s277941/ESE-project/(list of files, cad)

Other CAD files:
ORCAD_PERSONAL_LIBRARY/FOOTPRINTS/0603_c.psm
ORCAD_PERSONAL_LIBRARY/FOOTPRINTS/0603_l.psm
ORCAD_PERSONAL_LIBRARY/FOOTPRINTS/0603_r.psm
ORCAD_PERSONAL_LIBRARY/FOOTPRINTS/an043_patch_antenna.psm
ORCAD_PERSONAL_LIBRARY/FOOTPRINTS/beadc1608x95n.psm
ORCAD_PERSONAL_LIBRARY/FOOTPRINTS/blm18he152sn1.psm
ORCAD_PERSONAL_LIBRARY/FOOTPRINTS/capc0603x33n.psm
ORCAD_PERSONAL_LIBRARY/FOOTPRINTS/indc1608x90n.psm
ORCAD_PERSONAL_LIBRARY/FOOTPRINTS/molex_105164-0001.psm
ORCAD_PERSONAL_LIBRARY/FOOTPRINTS/my_qmatrix_button.psm
ORCAD_PERSONAL_LIBRARY/FOOTPRINTS/q-matrix-button.psm
ORCAD_PERSONAL_LIBRARY/FOOTPRINTS/qfn45p400x400x90-29n-d.psm
ORCAD_PERSONAL_LIBRARY/FOOTPRINTS/qmatrix_button.psm
ORCAD_PERSONAL_LIBRARY/FOOTPRINTS/qmatrix_button_top.psm
ORCAD_PERSONAL_LIBRARY/FOOTPRINTS/resc1608x50n.psm
ORCAD_PERSONAL_LIBRARY/FOOTPRINTS/samtec_ftsh-105-01-l-d-k.psm
ORCAD_PERSONAL_LIBRARY/FOOTPRINTS/sm02b-srss-tblfsn.psm
ORCAD_PERSONAL_LIBRARY/FOOTPRINTS/smd_cc2640r2f_rgz_48.psm
ORCAD_PERSONAL_LIBRARY/FOOTPRINTS/smd_max1555.psm
ORCAD_PERSONAL_LIBRARY/FOOTPRINTS/smd_max17048.psm
ORCAD_PERSONAL_LIBRARY/FOOTPRINTS/smd_max1759.psm
ORCAD_PERSONAL_LIBRARY/FOOTPRINTS/smd_sc20s-7pf20ppm.psm
ORCAD_PERSONAL_LIBRARY/FOOTPRINTS/smd_smlp36.psm
ORCAD_PERSONAL_LIBRARY/FOOTPRINTS/smd_tsx-3225240000mf15x-ac3.psm
ORCAD_PERSONAL_LIBRARY/FOOTPRINTS/sw_pcm12smtr.psm
