s277941/ESE-project/(list of files, drawings)

Other design files:
BLE_TH_Sensor/BLE_TH_SENSOR.DSN
BLE_TH_Sensor/ble_th_sensor.opj
FullAdder/FULLADDER.DSN
FullAdder/FullAdder.opj
Launchpad/LAUNCHPAD.DSN
Launchpad/Launchpad.opj
ORCAD_PERSONAL_LIBRARY/ORCAD_MY_LIBRARY.OLB
ORCAD_PERSONAL_LIBRARY/orcad_my_library.opj
