s277941/ESE-project/Launchpad/allegro/art_param.txt

DEVICE-TYPE           GERBER_RS274X
OUTPUT-UNITS          MM
FILM-SIZE             11000000 12000000
FORMAT                2.5
ABORT-ON-ERROR        NO
SCALE                 1
SUPPRESS-LEAD-ZEROES  YES
SUPPRESS-TRAIL-ZEROES NO
SUPPRESS-EQUAL        YES
UNDEF-APT-CONT        NO
