s277941/ESE-project/BLE_TH_Sensor/nc_param.txt

INTEGER-PLACES         3
DECIMAL-PLACES         3
X-OFFSET               0.000000
Y-OFFSET               0.000000
FEEDRATE               1
COORDINATES            ABSOLUTE
OUTPUT-UNITS           METRIC
TOOL-ORDER             INCREASING
REPEAT-CODES           NO
SUPPRESS-LEAD-ZEROES   YES
SUPPRESS-TRAIL-ZEROES  NO
SUPPRESS-EQUAL         NO
TOOL-SELECT            YES
OPTIMIZE_DRILLING      NO
ENHANCED_EXCELLON      YES
HEADER                 none
LEADER                 12
CODE                   ASCII
SEPARATE               YES
SEPARATE-ROUTING       NO
DRILLING               LAYER-PAIR
BACKDRILL              NO
CAVITY                 NO
COUNTER                NO
TOLERANCE_DRILL        YES
TOLERANCE_TRAVEL       NO
TOOL_SIZE              NO
ROTATION               NO
NON_STANDARD           NO
TOTAL_DRILL            NO
SEPARATE_SLOT          NO
SUPPRESS_TOLERANCE     NO
SUPPRESS_TOOLSIZE      NO
SUPPRESS_ROTATION      NO
