s277941/ESE-project/(commit log)

2020-11-21 Added part MAX1759 to library
    [ORCAD_MY_LIBRARY.OLB, ble_th_sensor.opj, orcad_my_library.opj]
2020-11-23 Added part TI-CC2640
    [ORCAD_MY_LIBRARY.OLB, orcad_my_library.opj]
2020-11-25 touch sensor
    [FULLADDER.DSN, FULLADDER.brd, FullAdder.opj, ORCAD_MY_LIBRARY.OLB, orcad_my_library.opj]
2020-11-25 Added more parts
    [ORCAD_MY_LIBRARY.OLB, orcad_my_library.opj]
2020-11-27 Created launchpad project
    [LAUNCHPAD.DSN, Launchpad.opj]
2020-11-27 Some work done
    [Conn_Molex_51021-0300.olb, LAUNCHPAD.DSN, Launchpad.opj, ORCAD_MY_LIBRARY.OLB, orcad_my_library.opj]
2020-11-27 Test push andrea
    [LAUNCHPAD.DSN]
2020-11-27 Everything resetted
    [LAUNCHPAD.DSN]
2020-11-27 General fix
    [Conn_Molex_51021-0300.olb, Launchpad.opj]
2020-11-28 Inserted title
    [LAUNCHPAD.DSN, Launchpad.opj]
2020-11-28 battery charger
    [Conn_Molex_1051640001.olb, LAUNCHPAD.DSN, Launchpad.opj]
2020-11-28 level meter
    [LAUNCHPAD.DSN]
2020-11-28 Completed power page
    [LAUNCHPAD.DSN, Launchpad.opj]
2020-11-29 Started drawing schematic for the touch-sensor
    [AT42QT2160-MMUR.OLB, LAUNCHPAD.DSN, Launchpad.opj, ORCAD_MY_LIBRARY.OLB, orcad_my_library.opj]
2020-12-01 Finished drawing touch sensor
    [LAUNCHPAD.DSN, Launchpad.opj]
2020-12-01 Started drawing the schematic of the microcontroller
    [BLM18HE152SN1D.OLB, LAUNCHPAD.DSN, Launchpad.opj, ORCAD_MY_LIBRARY.OLB, SC20S-7PF20PPM.OLB, TSX-3225240000MF15X-AC3.OLB, sc20s-7pf20ppm.opj, tsx-3225240000mf15x-ac3.opj]
2020-12-02 Finished schematic
    [LAUNCHPAD.DSN, Launchpad.opj, ORCAD_MY_LIBRARY.OLB, orcad_my_library.opj]
2020-12-03 Fixed some errors
    [LAUNCHPAD.DSN, Launchpad.opj, ORCAD_MY_LIBRARY.OLB, orcad_my_library.opj]
2020-12-04 Added JTAG
    [FTSH-105-01-L-D-RA-K.OLB, LAUNCHPAD.DSN, Launchpad.opj, ORCAD_MY_LIBRARY.OLB, orcad_my_library.opj]
2020-12-04 Some changes
    [Launchpad.opj]
2020-12-05 All the parts merged in my_orcad_personal_library.olb
    [LAUNCHPAD.DSN, Launchpad.opj, ORCAD_MY_LIBRARY.OLB, conn_molex_1051640001.opj, conn_molex_51021-0300.opj]
2020-12-05 Deleted not needed .olb library files
    [AT42QT2160-MMUR.OLB, BLM18HE152SN1D.OLB, Conn_Molex_1051640001.olb, Conn_Molex_51021-0300.olb, FTSH-105-01-L-D-RA-K.OLB, Launchpad.opj, SC20S-7PF20PPM.OLB, TSX-3225240000MF15X-AC3.OLB]
2020-12-05 Started drawing footprints
    [Launchpad.opj, smd_cc2640r2f_rgz_48.psm, smd_max1555.psm, smd_max1759.psm]
2020-12-05 Added more footprints
    [orcad_my_library.opj, qfn45p400x400x90-29n-d.psm, smd_max17048.psm]
2020-12-07 More footprints
    [LAUNCHPAD.DSN, Launchpad.opj, ORCAD_MY_LIBRARY.OLB, molex_105164-0001.psm, orcad_my_library.opj, smd_sc20s-7pf20ppm.psm, smd_tsx-3225240000mf15x-ac3.psm]
2020-12-07 Added new switch
    [LAUNCHPAD.DSN, Launchpad.opj, ORCAD_MY_LIBRARY.OLB, orcad_my_library.opj, sw_pcm12smtr.psm]
2020-12-08 Completed drawing footprints
    [LAUNCHPAD.DSN, Launchpad.opj, ORCAD_MY_LIBRARY.OLB, beadc1608x95n.psm, capc0603x33n.psm, indc1608x90n.psm, orcad_my_library.opj, resc1608x50n.psm]
2020-12-10 Almost finished schematic!
    [LAUNCHPAD.DSN, Launchpad.opj, ORCAD_MY_LIBRARY.OLB, orcad_my_library.opj, qfn45p400x400x90-29n-d.psm, smd_cc2640r2f_rgz_48.psm]
2020-12-10 Completed all the footprints
    [0603_c.psm, 0603_l.psm, 0603_r.psm, LAUNCHPAD.DSN, Launchpad.opj, ORCAD_MY_LIBRARY.OLB, an043_patch_antenna.psm, blm18he152sn1.psm]
2020-12-11 Added Qmatrix-Button
    [LAUNCHPAD.DSN, Launchpad.opj, ORCAD_MY_LIBRARY.OLB, orcad_my_library.opj, q-matrix-button.psm]
2020-12-12 Completed schematic and all the footprints, ready for brd!
    [LAUNCHPAD.DSN, Launchpad.opj, ORCAD_MY_LIBRARY.OLB, my_qmatrix_button.psm, orcad_my_library.opj, qmatrix_button.psm]
2020-12-13 Added touch sensor on etch top
    [qmatrix_button_top.psm]
2020-12-14 Everything is ready and we can start drawing the PCB!
    [LAUNCHPAD.DSN, qmatrix_button_top.psm]
2020-12-14 Now everything of the schematic is finished!
    [LAUNCHPAD.DSN, Launchpad.opj, ORCAD_MY_LIBRARY.OLB, orcad_my_library.opj]
2020-12-14 Started PCB design
    [LAUNCHPAD.DSN, LAUNCHPAD.brd, Launchpad.opj, ORCAD_MY_LIBRARY.OLB, cases.cfg, molex_105164-0001.psm, orcad_my_library.opj, smd_smlp36.psm]
2020-12-15 Checkpoint 0
    [LAUNCHPAD.brd, qfn45p400x400x90-29n-d.psm]
2020-12-15 All the components putted on the PCB
    [LAUNCHPAD.DSN, LAUNCHPAD.brd, Launchpad.opj, orcad_my_library.opj]
2020-12-15 Fixed Antenna and preliminary position setted!
    [LAUNCHPAD.DSN, LAUNCHPAD.brd, LAUNCHPAD_checkpoint0.brd, Launchpad.opj]
2020-12-15 Drawed a line
    [LAUNCHPAD.brd, Launchpad.opj]
2020-12-16 Changed something!
    [LAUNCHPAD.DSN, LAUNCHPAD.brd, LAUNCHPAD_checkpoint0.brd, Launchpad.opj]
2020-12-16 Almost finished everything!
    [LAUNCHPAD.brd, cases.cfg]
2020-12-16 Completed almost everything
    [LAUNCHPAD.DSN, LAUNCHPAD.brd, LAUNCHPAD_checkpoint0.brd, Launchpad.opj]
2020-12-17 Started routing matrix
    [LAUNCHPAD.brd]
2020-12-18 Some modifications
    [LAUNCHPAD.brd]
2020-12-21 Minor changes
    [LAUNCHPAD.brd]
2020-12-21 Others minor changes
    [LAUNCHPAD.brd]
2020-12-21 Updated schematics
    [LAUNCHPAD.DSN, Launchpad.opj]
2020-12-21 Gerbers exported
    [LAUNCHPAD.brd, art_param.txt, nc_param.txt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]
2021-01-11 Added more comments to schematic, started rev 1.1
    [LAUNCHPAD.DSN, LAUNCHPAD_checkpoint0.brd]
2021-01-16 Improved the micro 01
    [LAUNCHPAD.brd]
2021-01-16 Improved also the touch sensor maybe...
    [LAUNCHPAD.brd, Launchpad.opj]
2021-01-16 Maybe now it is fine
    [LAUNCHPAD.brd, Launchpad.opj]
2021-01-17 Other improvements
    [LAUNCHPAD.brd, Launchpad.opj]
2021-01-17 I think that all the possible improved where implemented
    [LAUNCHPAD.brd, Launchpad.opj]
2021-01-18 Final version
    [LAUNCHPAD.brd]
2021-01-19 Probabily final PCB
    [LAUNCHPAD.brd]
2021-01-19 Fixed problems on silkscreen. Generated gerbers.
    [LAUNCHPAD.brd, smd_max1555.psm, smd_max17048.psm, smd_sc20s-7pf20ppm.psm, smd_tsx-3225240000mf15x-ac3.psm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]
2021-01-20 minor upgrades
    [0603_l.psm, LAUNCHPAD.brd, smd_cc2640r2f_rgz_48.psm]
2021-01-20 Before starting video
    [Launchpad.opj, orcad_my_library.opj]
